MuskanSinhaPi/F1-race-reactive-lighting/assets/mode-reference-table.png

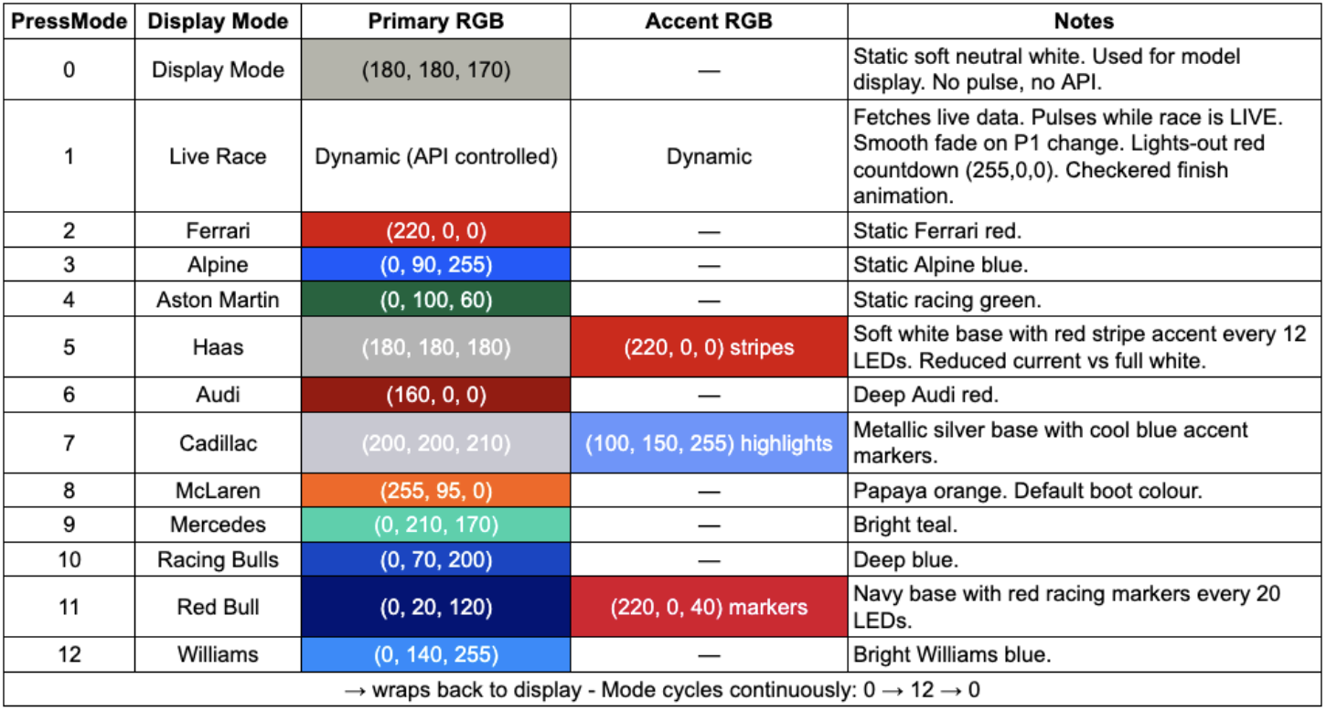
assets/mode-reference-table.png
