MuskanSinhaPi/F1-race-reactive-lighting/assets/system-architecture.png

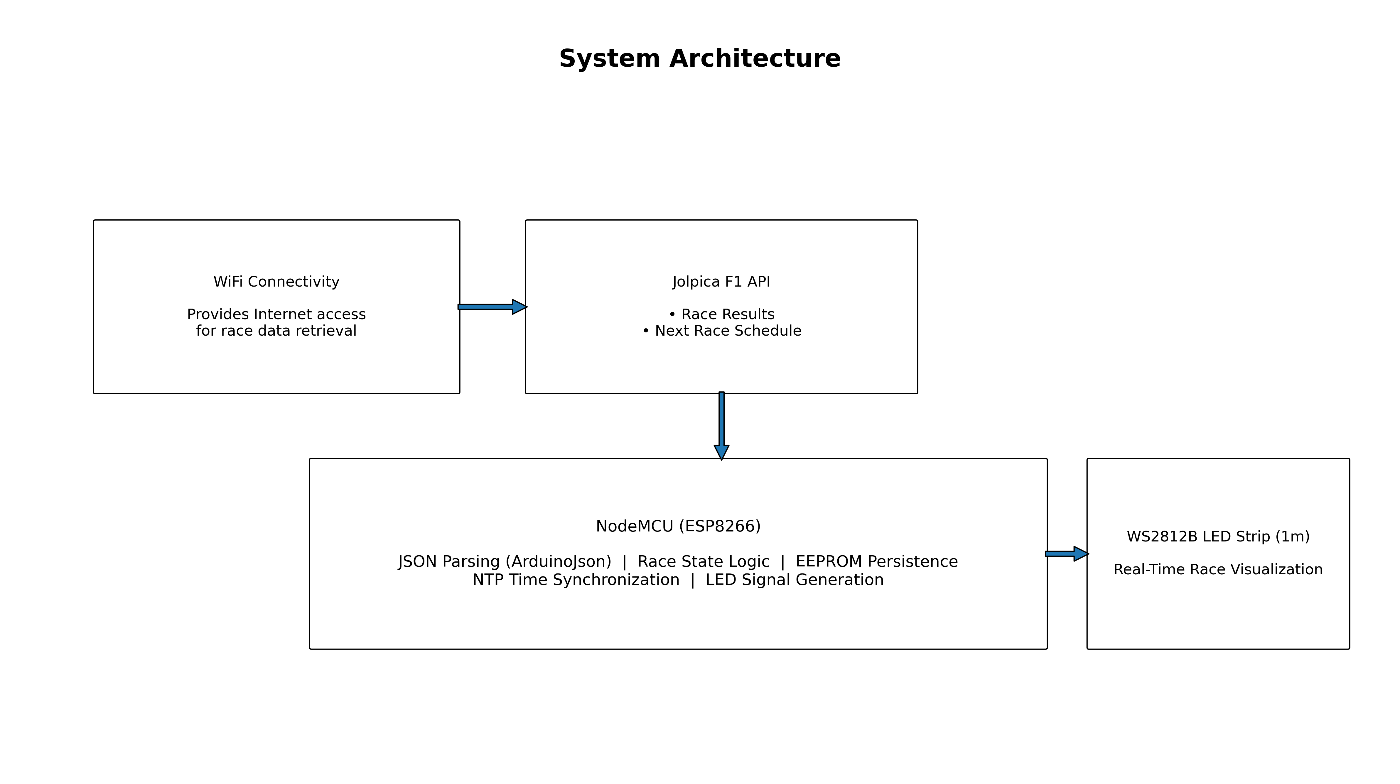
assets/system-architecture.png
