MuskanSinhaPi/F1-race-reactive-lighting/nano.ino

#include <Adafruit_NeoPixel.h>
#include <SoftwareSerial.h>

#define STRIP_PIN   6
#define NUM_LEDS    131
#define ESP_RX_PIN  8
#define ESP_TX_PIN  9

#define CMD_DISPLAY      0
#define CMD_PULSE      255
#define CMD_CHECKERED   99
#define CMD_LIGHTS_OUT  77

Adafruit_NeoPixel strip(NUM_LEDS, STRIP_PIN, NEO_GRB + NEO_KHZ800);
SoftwareSerial espSerial(ESP_RX_PIN, ESP_TX_PIN);

// ================= COLOR TRACKING =================
int currentR = 0, currentG = 0, currentB = 0;
int currentTeam = -1;

// ================= PULSE =================
bool pulsing      = false;
float pulseFactor = 0.3;
bool pulseRising  = true;
int pulseR = 0, pulseG = 0, pulseB = 0;
unsigned long lastPulse = 0;

// ================= TEAM COLORS =================
struct Color { int r, g, b; };
Color teamColors[] = {
  {  0,   0,   0},
  {220,   0,   0},  // 1  Ferrari
  {  0,  90, 255},  // 2  Alpine
  {  0, 100,  60},  // 3  Aston Martin
  {180, 180, 180},  // 4  Haas (soft white)
  {160,   0,   0},  // 5  Audi
  {200, 200, 210},  // 6  Cadillac (soft silver)
  {255,  95,   0},  // 7  McLaren
  {  0, 210, 170},  // 8  Mercedes
  {  0,  70, 200},  // 9  Racing Bulls
  {  0,  20, 120},  // 10 Red Bull (deep navy)
  {  0, 140, 255},  // 11 Williams
};

// ================= ACCENT PIXELS =================
// Stores per-pixel accent colours for teams that have highlight LEDs.
// doPulse() re-applies these after setting the base colour so they
// are never wiped by the pulse cycle.
struct AccentPixel { int index; int r; int g; int b; };
AccentPixel accentPixels[25];
int numAccentPixels = 0;

// ==========================================================
// SETUP
// ==========================================================

void setup() {
  Serial.begin(115200);
  espSerial.begin(9600);

  strip.begin();
  strip.setBrightness(120);
  strip.show();

  // Default to McLaren on first boot
  setTeamColor(7);
}

// ==========================================================
// LOOP
// ==========================================================

void loop() {

  // Commands from NodeMCU
  if (espSerial.available()) {
    int cmd = espSerial.read();   // raw byte, 0-255, no parsing/toInt() involved
    Serial.print("CMD: ");
    Serial.println(cmd);
    handleCommand(cmd);
  }

  // Commands from USB Serial Monitor (for testing)
  if (Serial.available()) {
    String msg = Serial.readStringUntil('\n');
    msg.trim();
    if (msg.length() == 0) return;
    int cmd = msg.toInt();
    Serial.print("USB CMD: ");
    Serial.println(cmd);
    handleCommand(cmd);
  }

  if (pulsing && millis() - lastPulse > 30) {
    lastPulse = millis();
    doPulse();
  }
}

// ==========================================================
// COMMAND HANDLER
// ==========================================================

void handleCommand(int cmd) {
  if (cmd < 0 || cmd > 255) return;   // read() error sentinel or garbage

  if (cmd == CMD_CHECKERED) {
    pulsing = false;
    checkeredWipe();
    // Do NOT restore after checkered — wait for NodeMCU to send teamID
    return;
  }

  if (cmd == CMD_LIGHTS_OUT) {
    pulsing = false;
    lightsOutAnimation();
    restoreTeamAfterAnimation();
    pulsing = true;
    return;
  }

  if (cmd == CMD_PULSE) {
    pulseFactor = 0.3;
    pulseRising = true;
    lastPulse = millis();
    pulsing = true;
    return;
  }

  if (cmd == CMD_DISPLAY) {
    pulsing = false;
    numAccentPixels = 0;   // clear accents — display mode is plain warm white
    // IMPORTANT: DISPLAY is not a team colour.
    // Force the next team command to actually update the LEDs.
    currentTeam = -1;
    smoothFade(200, 200, 190);
    strip.setBrightness(150);
    strip.show();
    return;
  }

  if (cmd >= 1 && cmd <= 11) {
    pulsing = false;
    setTeamColor(cmd);
  }
}

// ==========================================================
// TEAM SETTER
// ==========================================================

void setTeamColor(int team) {
  if (team == currentTeam) return;  // already showing this team

  currentTeam = team;
  Color c = teamColors[team];
  smoothFade(c.r, c.g, c.b);
  pulseR = c.r;
  pulseG = c.g;
  pulseB = c.b;
  applyAccent(team);
}

// ==========================================================
// ACCENTS
// Stores accent pixel positions and colours in accentPixels[]
// so doPulse() can re-apply them each cycle without overwriting.
// ==========================================================

void applyAccent(int team) {
  numAccentPixels = 0;   // clear previous accent list

  if (team == 4) {          // Haas — red accents on soft white base
    for (int i = 0; i < NUM_LEDS; i++) {
      if (i % 12 == 0) {
        accentPixels[numAccentPixels++] = {i, 220, 0, 0};
        strip.setPixelColor(i, strip.Color(220, 0, 0));
      }
    }
  }

  if (team == 6) {          // Cadillac — blue accents on silver base
    for (int i = 0; i < NUM_LEDS; i++) {
      if (i % 15 == 0) {
        accentPixels[numAccentPixels++] = {i, 100, 150, 255};
        strip.setPixelColor(i, strip.Color(100, 150, 255));
      }
    }
  }

  if (team == 10) {         // Red Bull — red accents on deep navy base
    for (int i = 0; i < NUM_LEDS; i++) {
      if (i % 20 == 0) {
        accentPixels[numAccentPixels++] = {i, 220, 0, 40};
        strip.setPixelColor(i, strip.Color(220, 0, 40));
      }
    }
  }

  strip.show();
}

// ==========================================================
// SMOOTH FADE
// ==========================================================

void smoothFade(int tr, int tg, int tb) {
  int steps = 40;
  for (int i = 0; i <= steps; i++) {
    int r = currentR + (tr - currentR) * i / steps;
    int g = currentG + (tg - currentG) * i / steps;
    int b = currentB + (tb - currentB) * i / steps;
    for (int j = 0; j < NUM_LEDS; j++)
      strip.setPixelColor(j, strip.Color(r, g, b));
    strip.show();
    delay(15);
  }
  currentR = tr;
  currentG = tg;
  currentB = tb;
}

// ==========================================================
// PULSE
// Re-applies accent pixels after setting base colour so they
// are never overwritten by the pulse cycle.
// ==========================================================

void doPulse() {
  if (pulseRising) {
    pulseFactor += 0.01;
    if (pulseFactor >= 1.0) {
      pulseFactor = 1.0;
      pulseRising = false;
    }
  } else {
    pulseFactor -= 0.01;
    if (pulseFactor <= 0.3) {
      pulseFactor = 0.3;
      pulseRising = true;
    }
  }

  for (int i = 0; i < NUM_LEDS; i++) {
    strip.setPixelColor(i, strip.Color(
      pulseR * pulseFactor,
      pulseG * pulseFactor,
      pulseB * pulseFactor));
  }

  for (int i = 0; i < numAccentPixels; i++) {
    strip.setPixelColor(accentPixels[i].index, strip.Color(
      accentPixels[i].r * pulseFactor,
      accentPixels[i].g * pulseFactor,
      accentPixels[i].b * pulseFactor));
  }

  strip.show();
}

// ==========================================================
// LIGHTS OUT ANIMATION
// ==========================================================

void lightsOutAnimation() {
  for (int i = 5; i > 0; i--) {
    Serial.print("Lights Out in: ");
    Serial.println(i);
    for (int j = 0; j < NUM_LEDS; j++)
      strip.setPixelColor(j, strip.Color(255, 0, 0));
    strip.show();
    delay(300);
    strip.clear();
    strip.show();
    delay(700);
  }
}

// ==========================================================
// CHECKERED WIPE
// ==========================================================

void checkeredWipe() {
  for (int c = 0; c < 12; c++) {
    for (int offset = 0; offset < 8; offset++) {
      for (int i = 0; i < NUM_LEDS; i++) {
        int pattern = ((i + offset) / 4) % 2;
        strip.setPixelColor(i, pattern == 0
          ? strip.Color(240, 240, 240)
          : strip.Color( 20,  20,  20));
      }
      strip.show();
      delay(70);
    }
  }
  currentTeam = -1;  // reset so next setTeamColor() always fades correctly
}

// ==========================================================
// RESTORE AFTER ANIMATION
// ==========================================================

void restoreTeamAfterAnimation() {
  setTeamColor(currentTeam);
}
