MuskanSinhaPi/F1-race-reactive-lighting/(commit log)

2026-02-25 Revise README with project details and requirements
    Updated project name and added detailed overview, features, hardware and software requirements, wiring instructions, and API information.
2026-02-25 Add F1 race data display with LED control
    Initial implementation of an ESP8266-based F1 race data display with LED effects.
2026-02-25 Add system test and validation guide for LED display
    Added a comprehensive system test and validation guide for the F1 Live Race Reactive LED Display system, including multiple tests for hardware and software functionality.
2026-08-22 Implement next GP marquee functionality and corrected premature raceSunday trigger
    Added functions to build and update the next GP marquee with race information.
    [F1_LED_Controller.ino]
